petrinm/CellShaper/docs/top.png

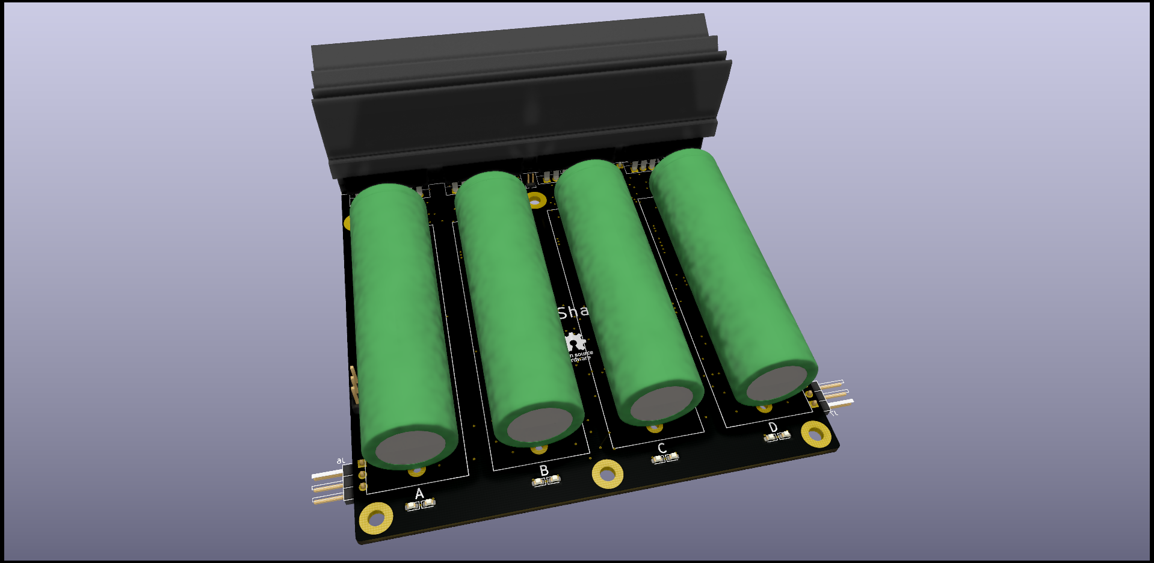
docs/top.png
