petrinm/CellShaper/docs/bottom.png

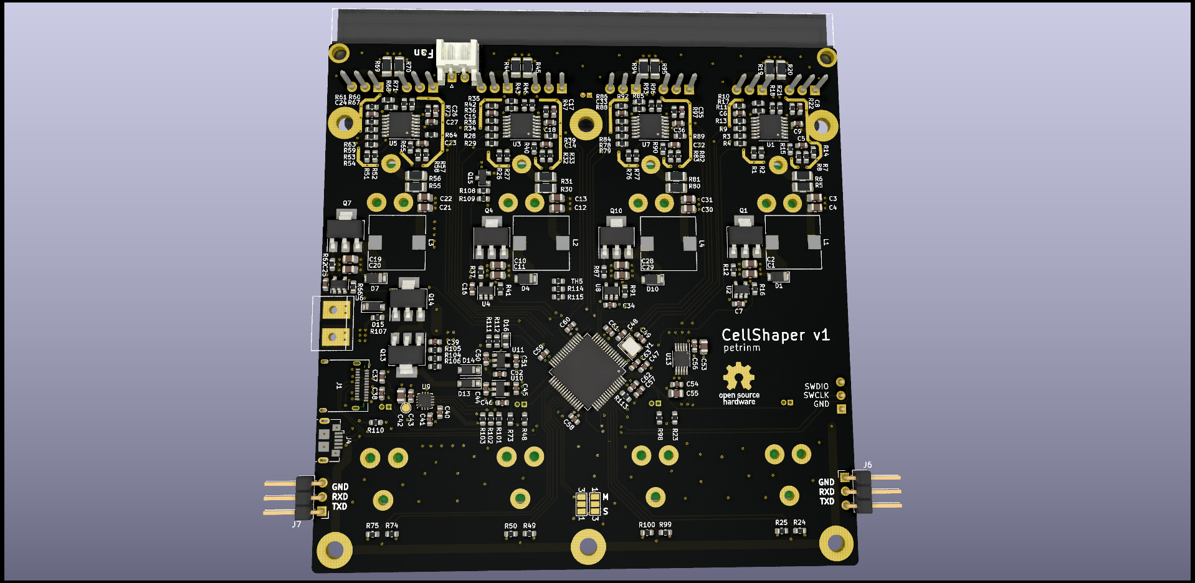
docs/bottom.png
