petrinm/CellShaper/README.md

# CellShaper
The ultimate 18650 battery cell tester
