petrinm/CellShaper/hw/v1/CellShaper.kicad_pcb

## KiCad design hw/v1/CellShaper.kicad_pcb (2020-07-15)

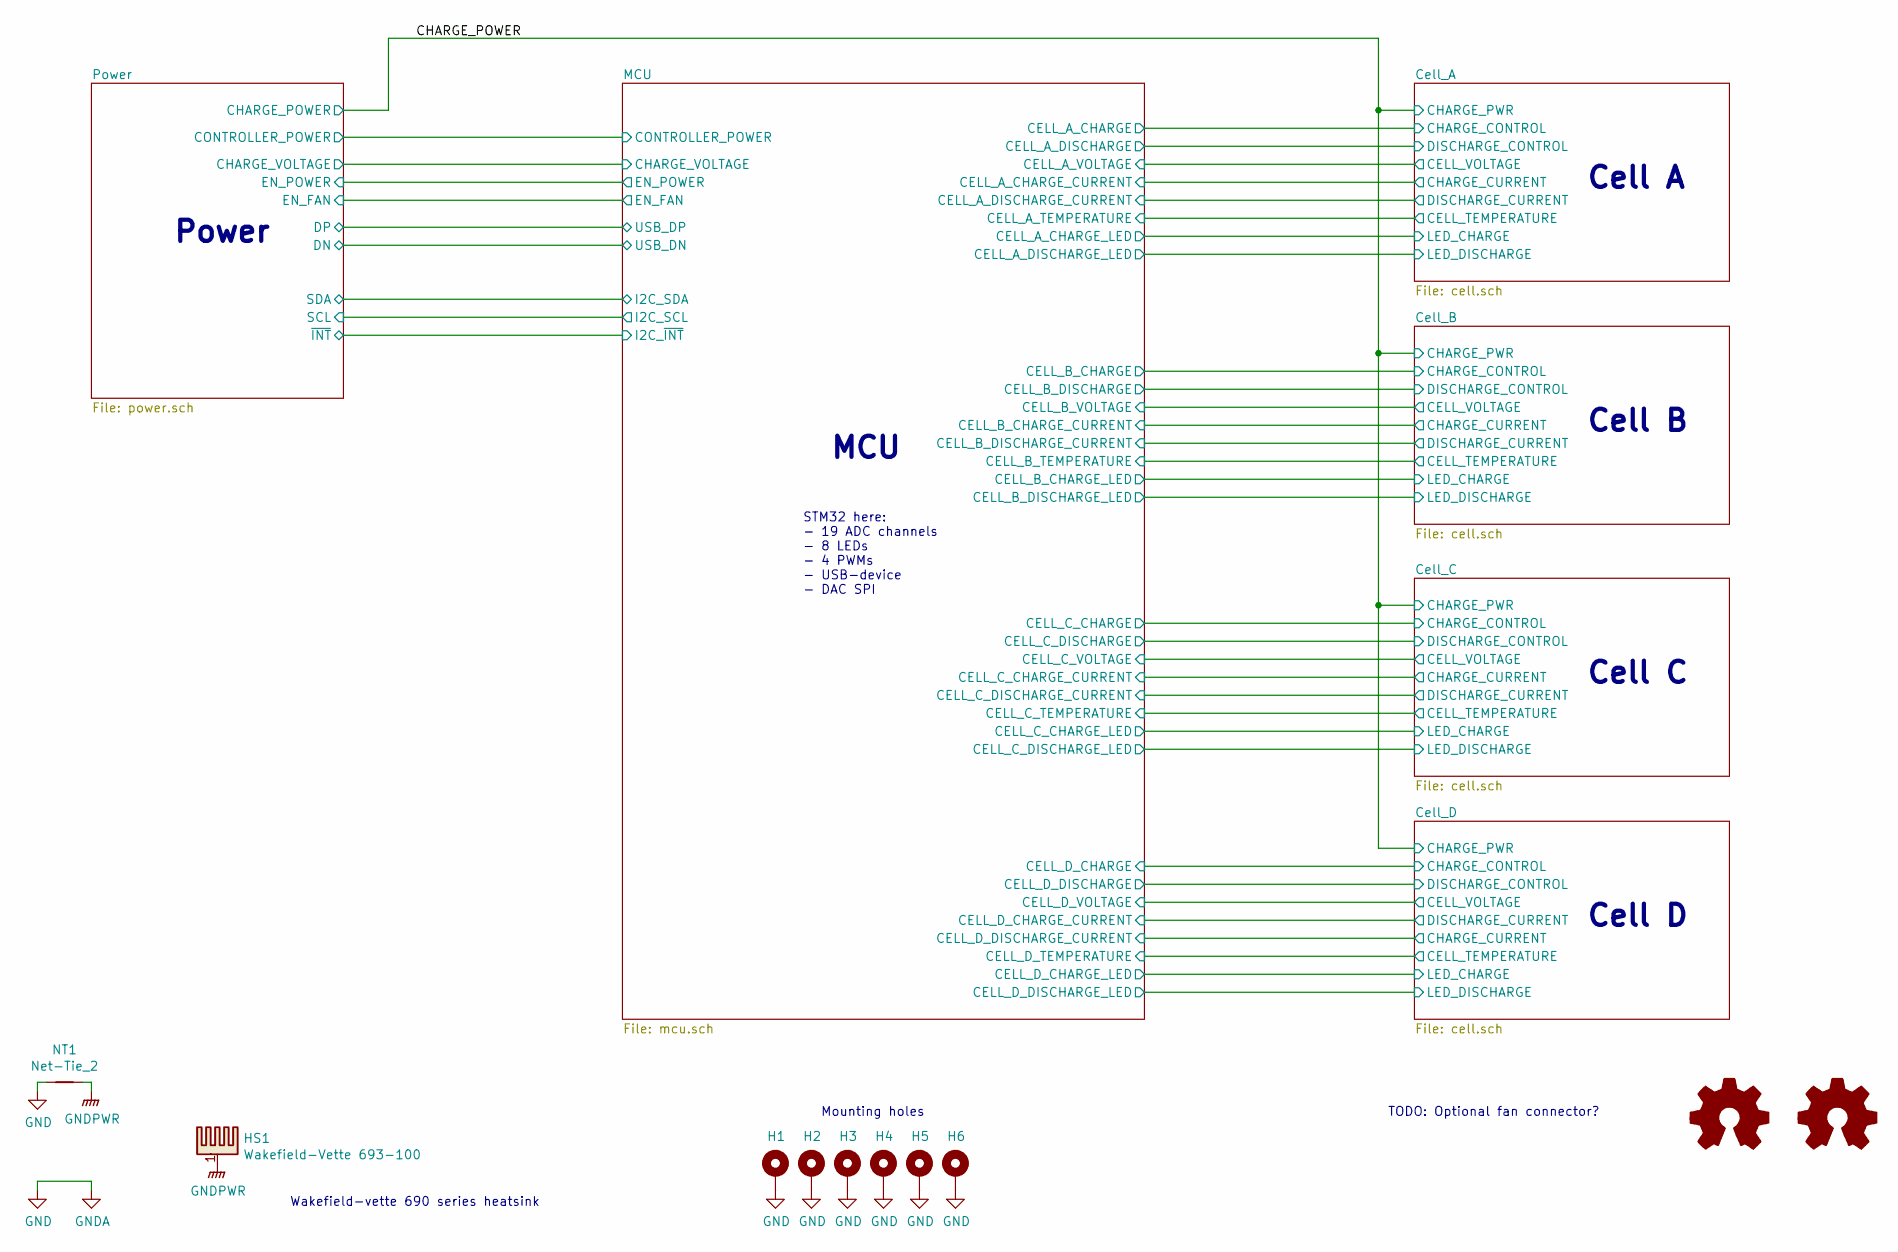
[picture p3: schematic CellShaper.sch]

Parts:
H1, H2, H3, H4, H5, H6: M3 hole; MountingHole_3.2mm_M3_Pad
HS1: Wakefield-Vette 693-100; Wakefield-vette_693-100
LOGO1: Logo_Open_Hardware_Small; OSHW-Logo_7.5x8mm_Copper
LOGO2: Logo_Open_Hardware_Small; OSHW-Logo_7.5x8mm_SilkScreen
NT1: Net-Tie_2; NetTie-2_SMD_Pad2.0mm

Connections:
GND: H1.1, H2.1, H3.1, H4.1, H5.1, H6.1, NT1.1; also elsewhere on the board
GNDPWR: HS1.1, NT1.2; also elsewhere on the board

Notes on the sheet:
Wakefield-vette 690 series heatsink
STM32 here: - 19 ADC channels - 8 LEDs - 4 PWMs - USB-device - DAC SPI
TODO: Optional fan connector?
Mounting holes
Cell A
Cell B
Cell D
Cell C
MCU
Power

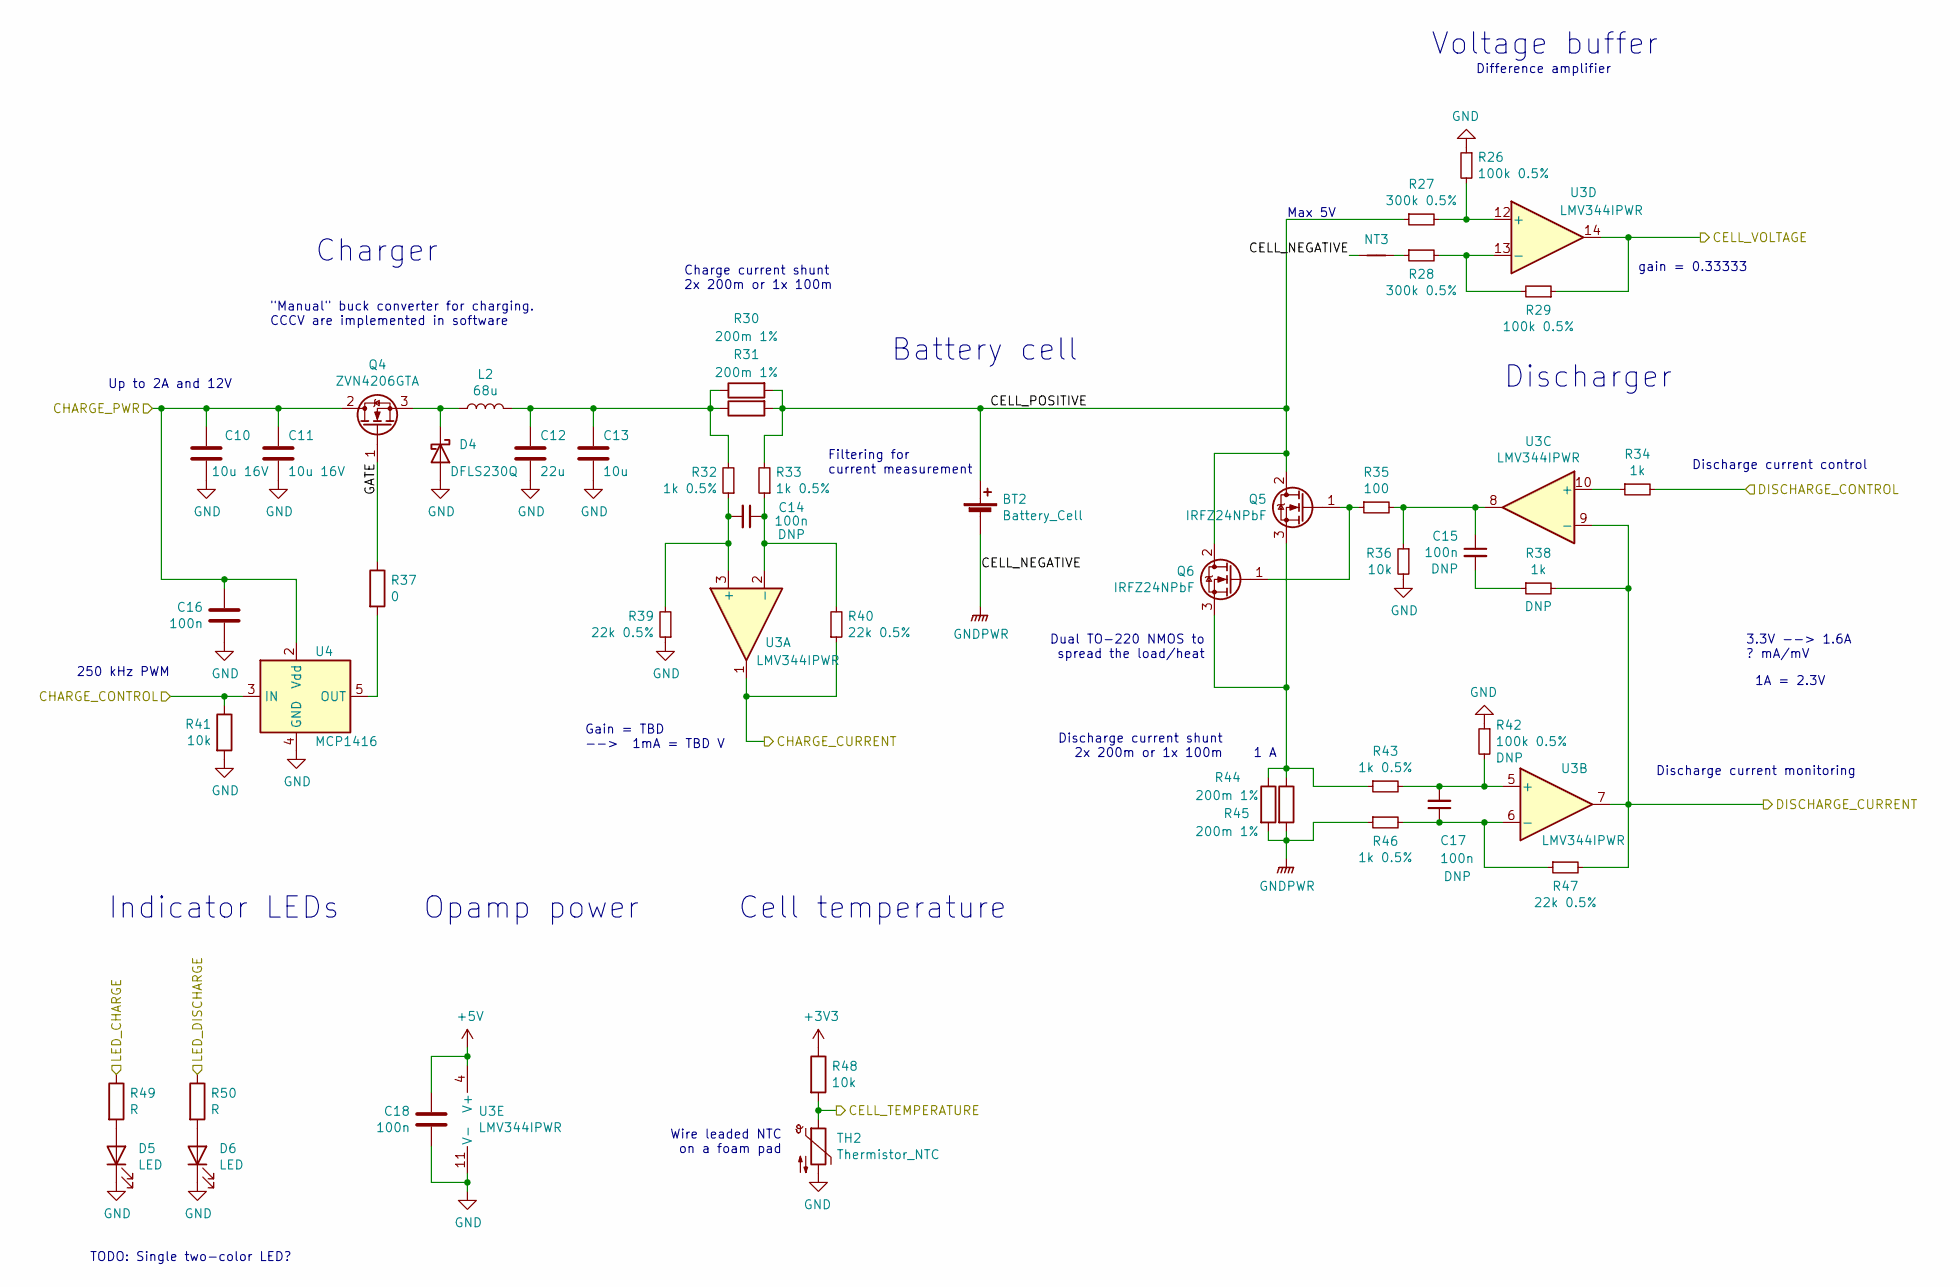
[picture p4: schematic cell.sch, CellShaper: Cell]

Parts:
BT1: Battery_Cell; BatteryHolder_Keystone_534_54
C1, C2: 10u 16V; C_0805_2012Metric
C3: 22u; C_0805_2012Metric
C4: 10u; C_0805_2012Metric
C5, C6, C7, C8, C9: 100n; C_0603_1608Metric
D1: DFLS230Q; D_PowerDI-123
D2, D3: LED; LED_0603_1608Metric
L1: 68u; L_Wuerth_HCM-1052
NT5: Net-Tie_2; NetTie-2_SMD_Pad0.5mm
Q1: ZVN4206GTA; SOT-223-3_TabPin2
Q2, Q3: IRFZ24NPbF; TO-220-3_Vertical
R1, R4, R17: 100k 0.5%; R_0603_1608Metric
R2, R3: 300k 0.5%; R_0603_1608Metric
R5, R6, R19, R20: 200m 1%; R_1206_3216Metric
R7, R8, R18, R21: 1k 0.5%; R_0603_1608Metric
R9, R13: 1k; R_0603_1608Metric
R10: 100; R_0603_1608Metric
R11, R16, R23: 10k; R_0603_1608Metric
R12: 0; R_0603_1608Metric
R14, R15, R22: 22k 0.5%; R_0603_1608Metric
R24, R25: R; R_0603_1608Metric
TH1: Thermistor_NTC; ContactThermistor
U1: LMV344IPWR; TSSOP-14_4.4x5mm_P0.65mm
U2: MCP1416; SOT-23-5

Connections:
+3V3: R23.1; also elsewhere on the board
+5V: C9.1, U1.4 (V+); also elsewhere on the board
/CHARGE_POWER: C1.1, C2.1, C7.1, Q1.2 (D), U2.2 (Vdd); also elsewhere on the board
/Cell_A/CELL_POSITIVE: BT1.1 (+), Q2.2 (D), Q3.2 (D), R2.1, R5.2, R6.2, R8.2
/Cell_A/GATE: Q1.1 (G), R12.1
/MCU/CELL_A_CHARGE: R16.1, U2.3 (IN); also elsewhere on the board
/MCU/CELL_A_CHARGE_CURRENT: R15.1, U1.1; also elsewhere on the board
/MCU/CELL_A_CHARGE_LED: R24.1; also elsewhere on the board
/MCU/CELL_A_DISCHARGE: R9.2; also elsewhere on the board
/MCU/CELL_A_DISCHARGE_CURRENT: R13.2, R22.2, U1.7, U1.9 (-); also elsewhere on the board
/MCU/CELL_A_DISCHARGE_LED: R25.1; also elsewhere on the board
/MCU/CELL_A_TEMPERATURE: R23.2, TH1.1; also elsewhere on the board
/MCU/CELL_A_VOLTAGE: R4.1, U1.14; also elsewhere on the board
GND: C1.2, C2.2, C3.2, C4.2, C7.2, C9.2, D1.2 (A), D2.1 (K), D3.1 (K), R1.1, R11.2, R14.1, R16.2, R17.1, TH1.2, U1.11 (V-), U2.4 (GND); also elsewhere on the board
GNDPWR: BT1.2 (-), NT5.1, R19.2, R20.2, R21.1; also elsewhere on the board
unnamed: C3.1, C4.1, L1.2, R5.1, R6.1, R7.2
unnamed: C5.1, R8.1, R15.2, U1.2 (-)
unnamed: C5.2, R7.1, R14.2, U1.3 (+)
unnamed: C6.1, R10.2, R11.1, U1.8
unnamed: C6.2, R13.1
unnamed: C8.1, R21.2, R22.1, U1.6 (-)
unnamed: C8.2, R17.2, R18.2, U1.5 (+)
unnamed: D1.1 (K), L1.1, Q1.3 (S)
unnamed: D2.2 (A), R24.2
unnamed: D3.2 (A), R25.2
unnamed: Q2.1 (G), Q3.1 (G), R10.1
unnamed: Q2.3 (S), Q3.3 (S), R18.1, R19.1, R20.1
unnamed: R1.2, R2.2, U1.12 (+)
unnamed: R3.2, R4.2, U1.13 (-)
unnamed: R9.1, U1.10 (+)
unnamed: R12.2, U2.5 (OUT)

Parts of its further copies:
BT2, BT3, BT4: Battery_Cell; BatteryHolder_Keystone_534_54
C10, C11, C19, C20, C28, C29: 10u 16V; C_0805_2012Metric
C12, C21, C30: 22u; C_0805_2012Metric
C13, C22, C31: 10u; C_0805_2012Metric
C14, C15, C16, C17, C18, C23, C24, C25, C26, C27, C32, C33, C34, C35, C36: 100n; C_0603_1608Metric
D4, D7, D10: DFLS230Q; D_PowerDI-123
D5, D6, D8, D9, D11, D12: LED; LED_0603_1608Metric
NT2, NT3, NT4: Net-Tie_2; NetTie-2_SMD_Pad0.5mm
Q4, Q7, Q10: ZVN4206GTA; SOT-223-3_TabPin2
Q5, Q6, Q8, Q9, Q11, Q12: IRFZ24NPbF; TO-220-3_Vertical
R26, R29, R42, R51, R54, R67, R76, R79, R92: 100k 0.5%; R_0603_1608Metric
R27, R28, R52, R53, R77, R78: 300k 0.5%; R_0603_1608Metric
R30, R31, R44, R45, R55, R56, R69, R70, R80, R81, R94, R95: 200m 1%; R_1206_3216Metric
R32, R33, R43, R46, R57, R58, R68, R71, R82, R83, R93, R96: 1k 0.5%; R_0603_1608Metric
R34, R38, R59, R63, R84, R88: 1k; R_0603_1608Metric
R35, R60, R85: 100; R_0603_1608Metric
R36, R41, R48, R61, R66, R73, R86, R91, R98: 10k; R_0603_1608Metric
R37, R62, R87: 0; R_0603_1608Metric
R39, R40, R47, R64, R65, R72, R89, R90, R97: 22k 0.5%; R_0603_1608Metric
R49, R50, R74, R75, R99, R100: R; R_0603_1608Metric
TH2, TH3, TH4: Thermistor_NTC; ContactThermistor
U3, U5, U7: LMV344IPWR; TSSOP-14_4.4x5mm_P0.65mm
U4, U6, U8: MCP1416; SOT-23-5

Connections of its further copies:
+3V3: R48.1, R73.1, R98.1; also elsewhere on the board
+5V: C18.1, C27.1, C36.1, U3.4 (V+), U5.4 (V+), U7.4 (V+); also elsewhere on the board
/CHARGE_POWER: C10.1, C11.1, C16.1, C19.1, C20.1, C25.1, C28.1, C29.1, C34.1, Q4.2 (D), Q7.2 (D), Q10.2 (D), U4.2 (Vdd), U6.2 (Vdd), U8.2 (Vdd); also elsewhere on the board
/Cell_B/CELL_POSITIVE: BT4.1 (+), Q11.2 (D), Q12.2 (D), R77.1, R80.2, R81.2, R83.2
/Cell_B/GATE: Q10.1 (G), R87.1
/Cell_C/CELL_POSITIVE: BT2.1 (+), Q5.2 (D), Q6.2 (D), R27.1, R30.2, R31.2, R33.2
/Cell_C/GATE: Q4.1 (G), R37.1
/Cell_D/CELL_POSITIVE: BT3.1 (+), Q8.2 (D), Q9.2 (D), R52.1, R55.2, R56.2, R58.2
/Cell_D/GATE: Q7.1 (G), R62.1
/MCU/CELL_B_CHARGE: R91.1, U8.3 (IN); also elsewhere on the board
/MCU/CELL_B_CHARGE_CURRENT: R90.1, U7.1; also elsewhere on the board
/MCU/CELL_B_CHARGE_LED: R99.1; also elsewhere on the board
/MCU/CELL_B_DISCHARGE: R84.2; also elsewhere on the board
/MCU/CELL_B_DISCHARGE_CURRENT: R88.2, R97.2, U7.7, U7.9 (-); also elsewhere on the board
/MCU/CELL_B_DISCHARGE_LED: R100.1; also elsewhere on the board
/MCU/CELL_B_TEMPERATURE: R98.2, TH4.1; also elsewhere on the board
/MCU/CELL_B_VOLTAGE: R79.1, U7.14; also elsewhere on the board
/MCU/CELL_C_CHARGE: R41.1, U4.3 (IN); also elsewhere on the board
/MCU/CELL_C_CHARGE_CURRENT: R40.1, U3.1; also elsewhere on the board
/MCU/CELL_C_CHARGE_LED: R49.1; also elsewhere on the board
/MCU/CELL_C_DISCHARGE: R34.2; also elsewhere on the board
/MCU/CELL_C_DISCHARGE_CURRENT: R38.2, R47.2, U3.7, U3.9 (-); also elsewhere on the board
/MCU/CELL_C_DISCHARGE_LED: R50.1; also elsewhere on the board
/MCU/CELL_C_TEMPERATURE: R48.2, TH2.1; also elsewhere on the board
/MCU/CELL_C_VOLTAGE: R29.1, U3.14; also elsewhere on the board
/MCU/CELL_D_CHARGE: R66.1, U6.3 (IN); also elsewhere on the board
/MCU/CELL_D_CHARGE_CURRENT: R63.2, R72.2, U5.7, U5.9 (-); also elsewhere on the board
/MCU/CELL_D_CHARGE_LED: R74.1; also elsewhere on the board
/MCU/CELL_D_DISCHARGE: R59.2; also elsewhere on the board
/MCU/CELL_D_DISCHARGE_CURRENT: R65.1, U5.1; also elsewhere on the board
/MCU/CELL_D_DISCHARGE_LED: R75.1; also elsewhere on the board
/MCU/CELL_D_TEMPERATURE: R73.2, TH3.1; also elsewhere on the board
/MCU/CELL_D_VOLTAGE: R54.1, U5.14; also elsewhere on the board
GND: C10.2, C11.2, C12.2, C13.2, C16.2, C18.2, C19.2, C20.2, C21.2, C22.2, C25.2, C27.2, C28.2, C29.2, C30.2, C31.2, C34.2, C36.2, D4.2 (A), D5.1 (K), D6.1 (K), D7.2 (A), D8.1 (K), D9.1 (K), D10.2 (A), D11.1 (K), D12.1 (K), R26.1, R36.2, R39.1, R41.2, R42.1, R51.1, R61.2, R64.1, R66.2, R67.1, R76.1, R86.2, R89.1, R91.2, R92.1, TH2.2, TH3.2, TH4.2, U3.11 (V-), U4.4 (GND), U5.11 (V-), U6.4 (GND), U7.11 (V-), U8.4 (GND); also elsewhere on the board
GNDPWR: BT2.2 (-), BT3.2 (-), BT4.2 (-), NT2.1, NT3.1, NT4.1, R44.2, R45.2, R46.1, R69.2, R70.2, R71.1, R94.2, R95.2, R96.1; also elsewhere on the board
unnamed 78: C12.1, C13.1, R30.1, R31.1, R32.2; also elsewhere on the board
unnamed: C14.1, R33.1, R40.2, U3.2 (-)
unnamed: C14.2, R32.1, R39.2, U3.3 (+)
unnamed: C15.1, R35.2, R36.1, U3.8
unnamed: C15.2, R38.1
unnamed: C17.1, R46.2, R47.1, U3.6 (-)
unnamed: C17.2, R42.2, R43.2, U3.5 (+)
unnamed 85: C21.1, C22.1, R55.1, R56.1, R57.2; also elsewhere on the board
unnamed: C23.1, R58.1, R65.2, U5.2 (-)
unnamed: C23.2, R57.1, R64.2, U5.3 (+)
unnamed: C24.1, R60.2, R61.1, U5.8
unnamed: C24.2, R63.1
unnamed: C26.1, R71.2, R72.1, U5.6 (-)
unnamed: C26.2, R67.2, R68.2, U5.5 (+)
unnamed 92: C30.1, C31.1, R80.1, R81.1, R82.2; also elsewhere on the board
unnamed: C32.1, R83.1, R90.2, U7.2 (-)
unnamed: C32.2, R82.1, R89.2, U7.3 (+)
unnamed: C33.1, R85.2, R86.1, U7.8
unnamed: C33.2, R88.1
unnamed: C35.1, R96.2, R97.1, U7.6 (-)
unnamed: C35.2, R92.2, R93.2, U7.5 (+)
unnamed 106: D4.1 (K), Q4.3 (S); also elsewhere on the board
unnamed: D5.2 (A), R49.2
unnamed: D6.2 (A), R50.2
unnamed 109: D7.1 (K), Q7.3 (S); also elsewhere on the board
unnamed: D8.2 (A), R74.2
unnamed: D9.2 (A), R75.2
unnamed 112: D10.1 (K), Q10.3 (S); also elsewhere on the board
unnamed: D11.2 (A), R99.2
unnamed: D12.2 (A), R100.2
unnamed: NT3.2, R28.1
unnamed: NT4.2, R53.1
unnamed: Q5.1 (G), Q6.1 (G), R35.1
unnamed: Q5.3 (S), Q6.3 (S), R43.1, R44.1, R45.1
unnamed: Q8.1 (G), Q9.1 (G), R60.1
unnamed: Q8.3 (S), Q9.3 (S), R68.1, R69.1, R70.1
unnamed: Q11.1 (G), Q12.1 (G), R85.1
unnamed: Q11.3 (S), Q12.3 (S), R93.1, R94.1, R95.1
unnamed: R26.2, R27.2, U3.12 (+)
unnamed: R28.2, R29.2, U3.13 (-)
unnamed: R34.1, U3.10 (+)
unnamed: R37.2, U4.5 (OUT)
unnamed: R51.2, R52.2, U5.12 (+)
unnamed: R53.2, R54.2, U5.13 (-)
unnamed: R59.1, U5.10 (+)
unnamed: R62.2, U6.5 (OUT)
unnamed: R76.2, R77.2, U7.12 (+)
unnamed: R78.2, R79.2, U7.13 (-)
unnamed: R84.1, U7.10 (+)
unnamed: R87.2, U8.5 (OUT)

Notes on the sheet:
1 A
Indicator LEDs
Discharger
Battery cell
Charger
Voltage buffer
250 kHz PWM
"Manual" buck converter for charging. CCCV are implemented in software
Charge current shunt 2x 200m or 1x 100m
Discharge current monitoring
Dual TO-220 NMOS to spread the load/heat
Filtering for current measurement
Gain = TBD --> 1mA = TBD V
Cell temperature
Opamp power
Up to 2A and 12V
Wire leaded NTC on a foam pad
TODO: Single two-color LED?
3.3V --> 1.6A ? mA/mV
Max 5V
1A = 2.3V
Difference amplifier
gain = 0.33333
Discharge current control
Discharge current shunt 2x 200m or 1x 100m

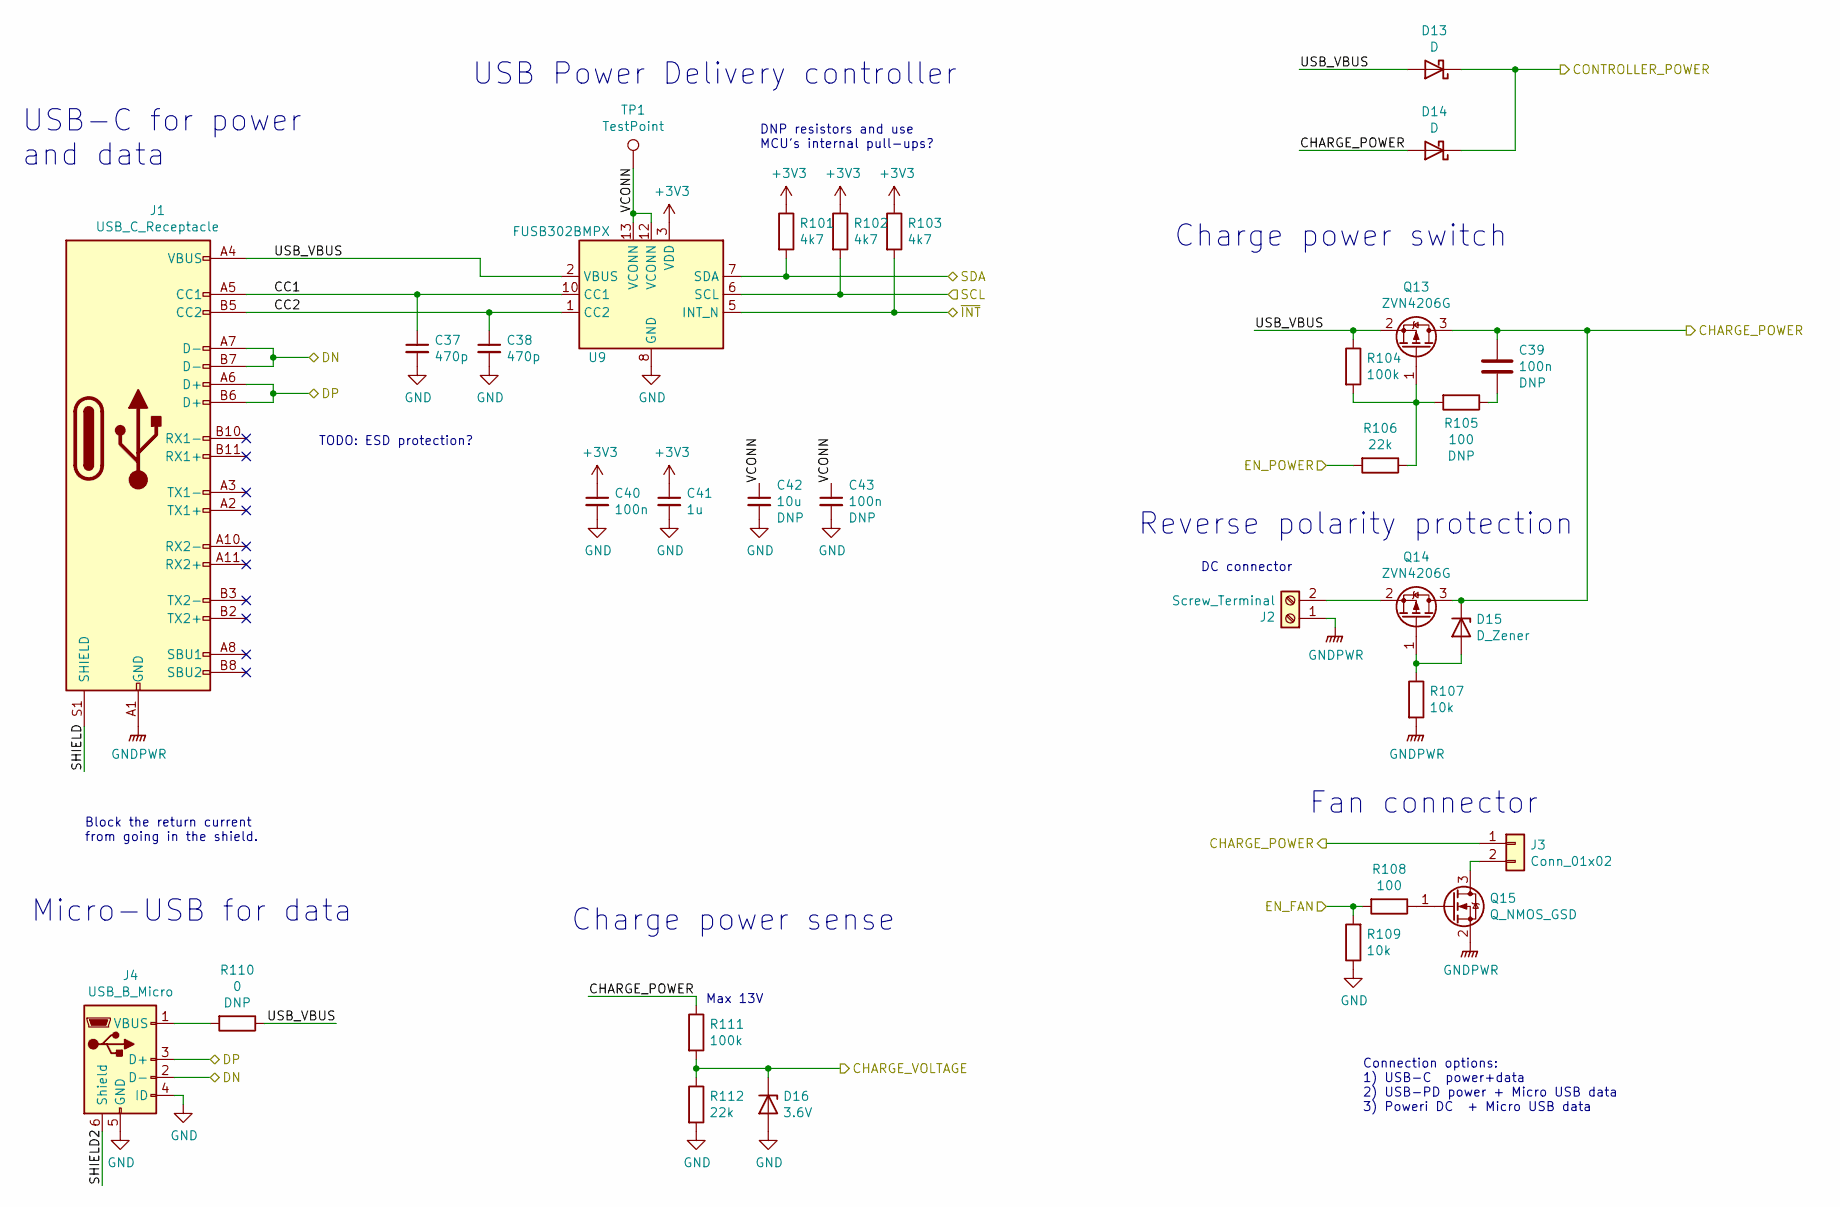
[picture p5: schematic power.sch, Cell Shaper: Power]

Parts:
C37, C38: 470p; C_0603_1608Metric
C39, C40, C43: 100n; C_0603_1608Metric
C41: 1u; C_0603_1608Metric
C42: 10u; C_0805_2012Metric
D13, D14: D; D_SOD-123
D15: D_Zener; D_SOD-123
D16: 3.6V; D_SOD-110
J1: USB_C_Receptacle; USB_C_Receptacle_Amphenol_12401610E4-2A
J2: Screw_Terminal; TerminalBlock_bornier-2_P5.08mm
J3: Conn_01x02; JST_EH_S2B-EH_1x02_P2.50mm_Horizontal
J4: USB_B_Micro; USB_Micro-B_GCT_USB3076-30-A
Q13, Q14: ZVN4206G; SOT-223-3_TabPin2
Q15: Q_NMOS_GSD; SOT-23
R101, R102, R103: 4k7; R_0603_1608Metric
R104, R111: 100k; R_0603_1608Metric
R105, R108: 100; R_0603_1608Metric
R106, R112: 22k; R_0603_1608Metric
R107, R109: 10k; R_0603_1608Metric
R110: 0; R_0603_1608Metric
TP1: TestPoint; TestPoint_Pad_D1.5mm
U9: FUSB302BMPX; WQFN-14-1EP_2.5x2.5mm_P0.5mm_EP1.45x1.45mm

Connections:
+3V3: C40.1, C41.1, R101.1, R102.1, R103.1, U9.3 (VDD), U9.4 (VDD); also elsewhere on the board
/CHARGE_POWER: C39.1, D14.2 (A), D15.1 (K), J3.1, Q13.3 (D), Q14.3 (D), R111.1; also elsewhere on the board
/MCU/CHARGE_VOLTAGE: D16.1 (K), R111.2, R112.1; also elsewhere on the board
/MCU/CONTROLLER_POWER: D13.1 (K), D14.1 (K); also elsewhere on the board
/MCU/EN_FAN: R108.2, R109.2; also elsewhere on the board
/MCU/EN_POWER: R106.2; also elsewhere on the board
/MCU/I2C_SCL: R102.2, U9.6 (SCL); also elsewhere on the board
/MCU/I2C_SDA: R101.2, U9.7 (SDA); also elsewhere on the board
/MCU/I2C_~INT: R103.2, U9.5 (INT_N); also elsewhere on the board
/Power/CC1: C37.1, J1.A5 (CC1), U9.10 (CC1), U9.11 (CC1)
/Power/CC2: C38.1, J1.B5 (CC2), U9.1 (CC2), U9.14 (CC2)
/Power/DN: J1.A7 (D-), J1.B7 (D-), J4.2 (D-); also elsewhere on the board
/Power/DP: J1.A6 (D+), J1.B6 (D+), J4.3 (D+); also elsewhere on the board
/Power/SHIELD: J1.S1 (SHIELD)
/Power/SHIELD2: J4.6 (Shield)
/Power/USB_VBUS: D13.2 (A), J1.A4 (VBUS), J1.A9 (VBUS), J1.B4 (VBUS), J1.B9 (VBUS), Q13.2 (S), R104.1, R110.1, U9.2 (VBUS)
/Power/VCONN: C42.1, C43.1, TP1.1, U9.12 (VCONN), U9.13 (VCONN)
GND: C37.2, C38.2, C40.2, C41.2, C42.2, C43.2, D16.2 (A), J4.4 (ID), J4.5 (GND), R109.1, R112.2, U9.8 (GND), U9.9 (GND), U9.15 (GND); also elsewhere on the board
GNDPWR: J1.A1 (GND), J1.A12 (GND), J1.B1 (GND), J1.B12 (GND), J2.1, Q15.2 (S), R107.2; also elsewhere on the board
unnamed: C39.2, R105.1
unnamed: D15.2 (A), Q14.1 (G), R107.1
unnamed: J2.2, Q14.2 (S)
unnamed: J3.2, Q15.3 (D)
unnamed: J4.1 (VBUS), R110.2
unnamed: Q13.1 (G), R104.2, R105.2, R106.1
unnamed: Q15.1 (G), R108.1

Notes on the sheet:
Max 13V
Reverse polarity protection
Charge power sense
USB Power Delivery controller
Connection options: 1) USB-C power+data 2) USB-PD power + Micro USB data 3) Poweri DC + Micro USB data
DNP resistors and use MCU's internal pull-ups?
Block the return current from going in the shield.
TODO: ESD protection?
Charge power switch
DC connector
Fan connector
Micro-USB for data
USB-C for power and data

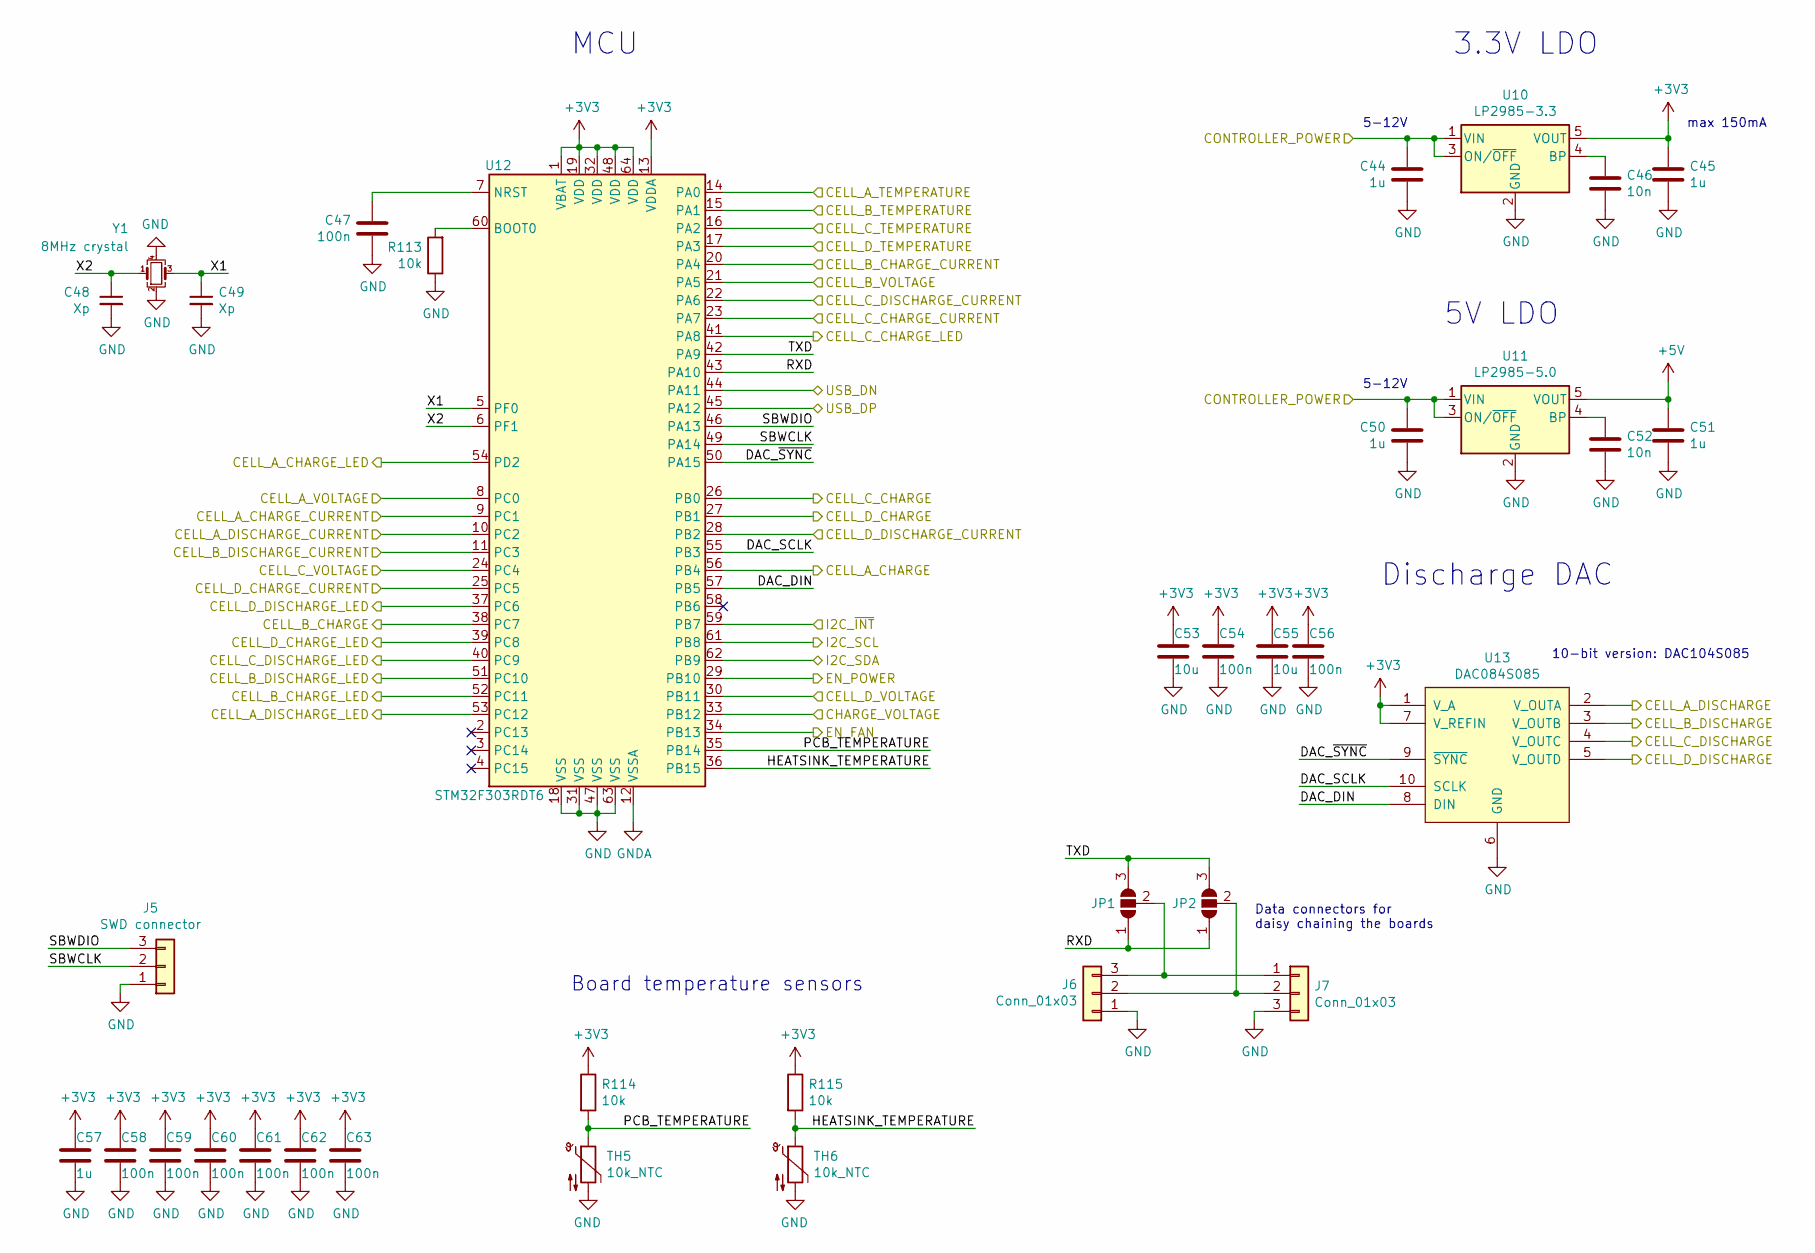
[picture p6: schematic mcu.sch, CellShaper: MCU]

Parts:
C44, C45, C50, C51, C57: 1u; C_0603_1608Metric
C46, C52: 10n; C_0603_1608Metric
C47, C54, C56, C58, C59, C60, C61, C62, C63: 100n; C_0603_1608Metric
C48, C49: Xp; C_0603_1608Metric
C53, C55: 10u; C_0805_2012Metric
J5: SWD connector; PinHeader_1x03_P2.54mm_Vertical
J6, J7: Conn_01x03; PinHeader_1x03_P2.54mm_Horizontal
JP1, JP2: SolderJumper_3_Open; SolderJumper-3_P1.3mm_Open_Pad1.0x1.5mm_NumberLabels
R113, R114, R115: 10k; R_0603_1608Metric
TH5: 10k_NTC; R_0603_1608Metric
TH6: 10k_NTC; PinHeader_1x02_P1.27mm_Vertical
U10: LP2985-3.3; SOT-23-5
U11: LP2985-5.0; SOT-23-5
U12: STM32F303RDT6; LQFP-64_10x10mm_P0.5mm
U13: DAC084S085; VSSOP-10_3x3mm_P0.5mm
Y1: 8MHz crystal; Crystal_SMD_Abracon_ABM8G-4Pin_3.2x2.5mm

Connections:
+3V3: C45.1, C53.2, C54.2, C55.2, C56.1, C57.1, C58.1, C59.1, C60.1, C61.1, C62.1, C63.1, R114.1, R115.1, U10.5 (VOUT), U12.1 (VBAT), U12.13 (VDDA), U12.19 (VDD), U12.32 (VDD), U12.48 (VDD), U12.64 (VDD), U13.1 (V_A), U13.7 (V_REFIN); also elsewhere on the board
+5V: C51.1, U11.5 (VOUT); also elsewhere on the board
/MCU/CELL_A_CHARGE: U12.56 (PB4); also elsewhere on the board
/MCU/CELL_A_CHARGE_CURRENT: U12.9 (PC1); also elsewhere on the board
/MCU/CELL_A_CHARGE_LED: U12.54 (PD2); also elsewhere on the board
/MCU/CELL_A_DISCHARGE: U13.2 (V_OUTA); also elsewhere on the board
/MCU/CELL_A_DISCHARGE_CURRENT: U12.10 (PC2); also elsewhere on the board
/MCU/CELL_A_DISCHARGE_LED: U12.53 (PC12); also elsewhere on the board
/MCU/CELL_A_TEMPERATURE: U12.14 (PA0); also elsewhere on the board
/MCU/CELL_A_VOLTAGE: U12.8 (PC0); also elsewhere on the board
/MCU/CELL_B_CHARGE: U12.38 (PC7); also elsewhere on the board
/MCU/CELL_B_CHARGE_CURRENT: U12.20 (PA4); also elsewhere on the board
/MCU/CELL_B_CHARGE_LED: U12.52 (PC11); also elsewhere on the board
/MCU/CELL_B_DISCHARGE: U13.3 (V_OUTB); also elsewhere on the board
/MCU/CELL_B_DISCHARGE_CURRENT: U12.11 (PC3); also elsewhere on the board
/MCU/CELL_B_DISCHARGE_LED: U12.51 (PC10); also elsewhere on the board
/MCU/CELL_B_TEMPERATURE: U12.15 (PA1); also elsewhere on the board
/MCU/CELL_B_VOLTAGE: U12.21 (PA5); also elsewhere on the board
/MCU/CELL_C_CHARGE: U12.26 (PB0); also elsewhere on the board
/MCU/CELL_C_CHARGE_CURRENT: U12.23 (PA7); also elsewhere on the board
/MCU/CELL_C_CHARGE_LED: U12.41 (PA8); also elsewhere on the board
/MCU/CELL_C_DISCHARGE: U13.4 (V_OUTC); also elsewhere on the board
/MCU/CELL_C_DISCHARGE_CURRENT: U12.22 (PA6); also elsewhere on the board
/MCU/CELL_C_DISCHARGE_LED: U12.40 (PC9); also elsewhere on the board
/MCU/CELL_C_TEMPERATURE: U12.16 (PA2); also elsewhere on the board
/MCU/CELL_C_VOLTAGE: U12.24 (PC4); also elsewhere on the board
/MCU/CELL_D_CHARGE: U12.27 (PB1); also elsewhere on the board
/MCU/CELL_D_CHARGE_CURRENT: U12.25 (PC5); also elsewhere on the board
/MCU/CELL_D_CHARGE_LED: U12.39 (PC8); also elsewhere on the board
/MCU/CELL_D_DISCHARGE: U13.5 (V_OUTD); also elsewhere on the board
/MCU/CELL_D_DISCHARGE_CURRENT: U12.28 (PB2); also elsewhere on the board
/MCU/CELL_D_DISCHARGE_LED: U12.37 (PC6); also elsewhere on the board
/MCU/CELL_D_TEMPERATURE: U12.17 (PA3); also elsewhere on the board
/MCU/CELL_D_VOLTAGE: U12.30 (PB11); also elsewhere on the board
/MCU/CHARGE_VOLTAGE: U12.33 (PB12); also elsewhere on the board
/MCU/CONTROLLER_POWER: C44.1, C50.1, U10.1 (VIN), U10.3 (ON/~OFF~), U11.1 (VIN), U11.3 (ON/~OFF~); also elsewhere on the board
/MCU/DAC_DIN: U12.57 (PB5), U13.8 (DIN)
/MCU/DAC_SCLK: U12.55 (PB3), U13.10 (SCLK)
/MCU/DAC_~SYNC: U12.50 (PA15), U13.9 (~SYNC)
/MCU/EN_FAN: U12.34 (PB13); also elsewhere on the board
/MCU/EN_POWER: U12.29 (PB10); also elsewhere on the board
/MCU/HEATSINK_TEMPERATURE: R115.2, TH6.1, U12.36 (PB15)
/MCU/I2C_SCL: U12.61 (PB8); also elsewhere on the board
/MCU/I2C_SDA: U12.62 (PB9); also elsewhere on the board
/MCU/I2C_~INT: U12.59 (PB7); also elsewhere on the board
/MCU/PCB_TEMPERATURE: R114.2, TH5.1, U12.35 (PB14)
/MCU/RXD: JP1.1 (A), JP2.1 (A), U12.43 (PA10)
/MCU/SBWCLK: J5.2, U12.49 (PA14)
/MCU/SBWDIO: J5.3, U12.46 (PA13)
/MCU/TXD: JP1.3 (B), JP2.3 (B), U12.42 (PA9)
/MCU/X1: C49.1, U12.5 (PF0), Y1.3
/MCU/X2: C48.1, U12.6 (PF1), Y1.1
/Power/DN: U12.44 (PA11); also elsewhere on the board
/Power/DP: U12.45 (PA12); also elsewhere on the board
GND: C44.2, C45.2, C46.2, C47.2, C48.2, C49.2, C50.2, C51.2, C52.2, C53.1, C54.1, C55.1, C56.2, C57.2, C58.2, C59.2, C60.2, C61.2, C62.2, C63.2, J5.1, J6.1, J7.3, R113.1, TH5.2, TH6.2, U10.2 (GND), U11.2 (GND), U12.12 (VSSA), U12.18 (VSS), U12.31 (VSS), U12.47 (VSS), U12.63 (VSS), U13.6 (GND), Y1.2, Y1.4; also elsewhere on the board
unnamed: C46.1, U10.4 (BP)
unnamed: C47.1, U12.7 (NRST)
unnamed: C52.1, U11.4 (BP)
unnamed: J6.2, J7.2, JP2.2 (C)
unnamed: J6.3, J7.1, JP1.2 (C)
unnamed: R113.2, U12.60 (BOOT0)

Notes on the sheet:
Data connectors for daisy chaining the boards
Board temperature sensors
10-bit version: DAC104S085
Discharge DAC
3.3V LDO
max 150mA
5-12V
5V LDO
MCU

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
