petrinm/CellShaper/hw/v1/CellShaper.kicad_pcb

## KiCad design hw/v1/CellShaper.kicad_pcb (continued)

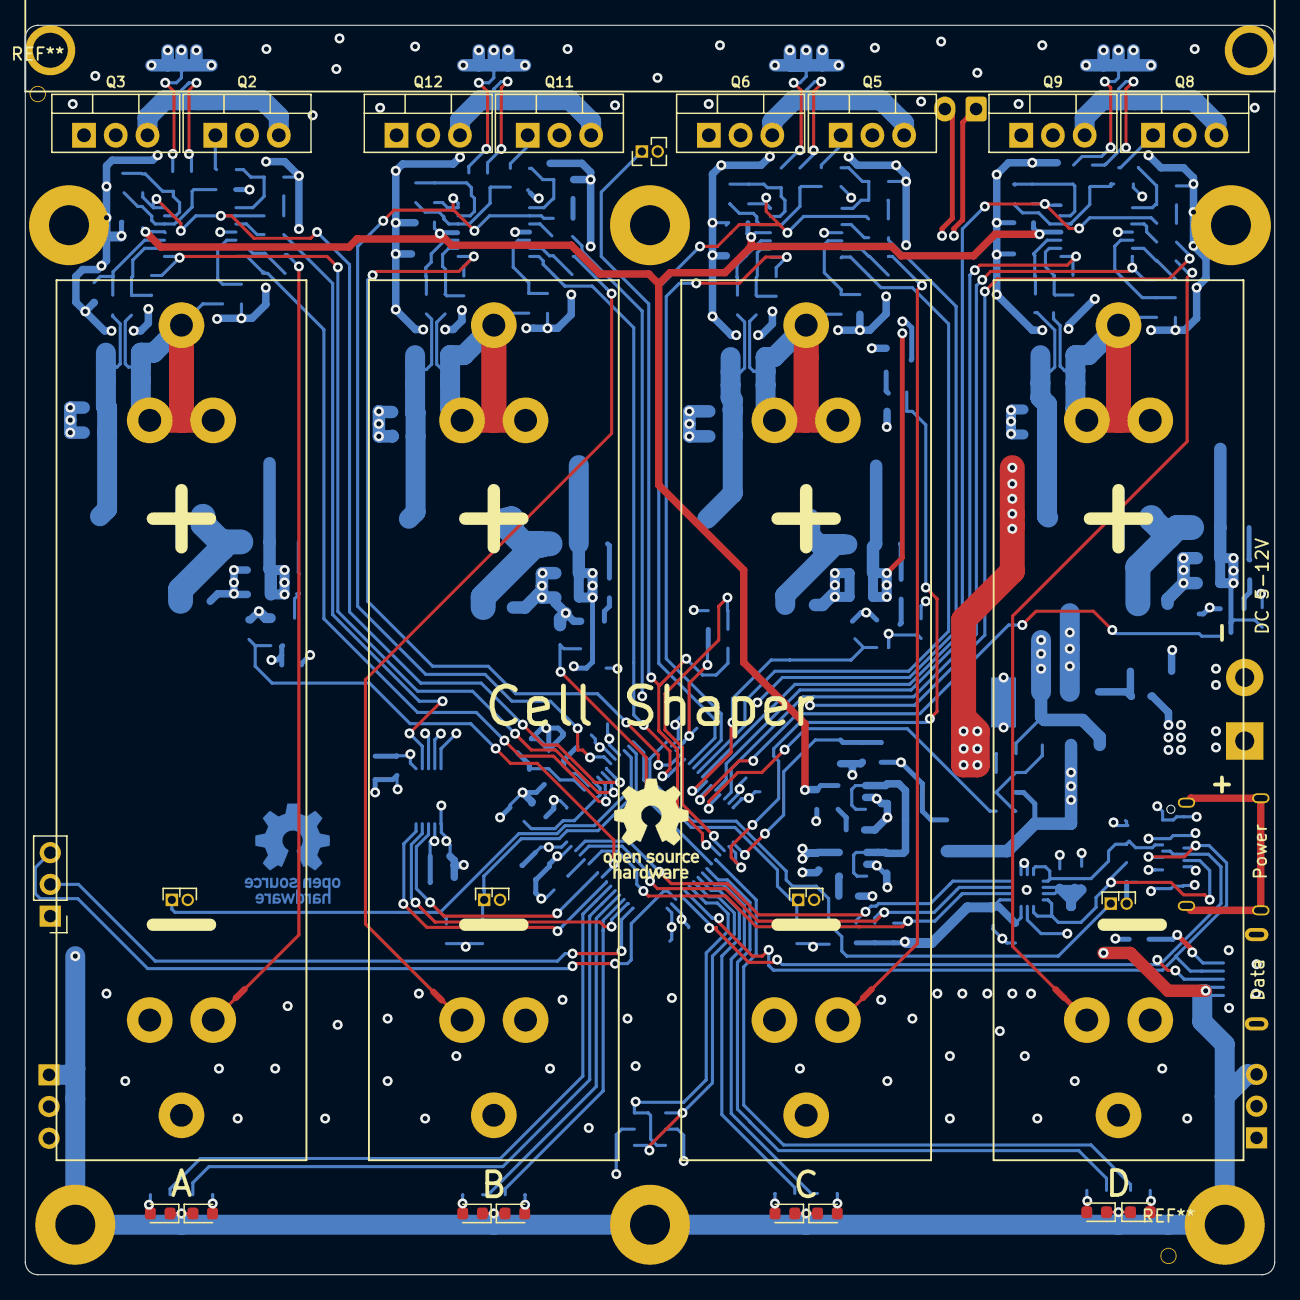
[picture p7: board CellShaper.kicad_pcb from above]

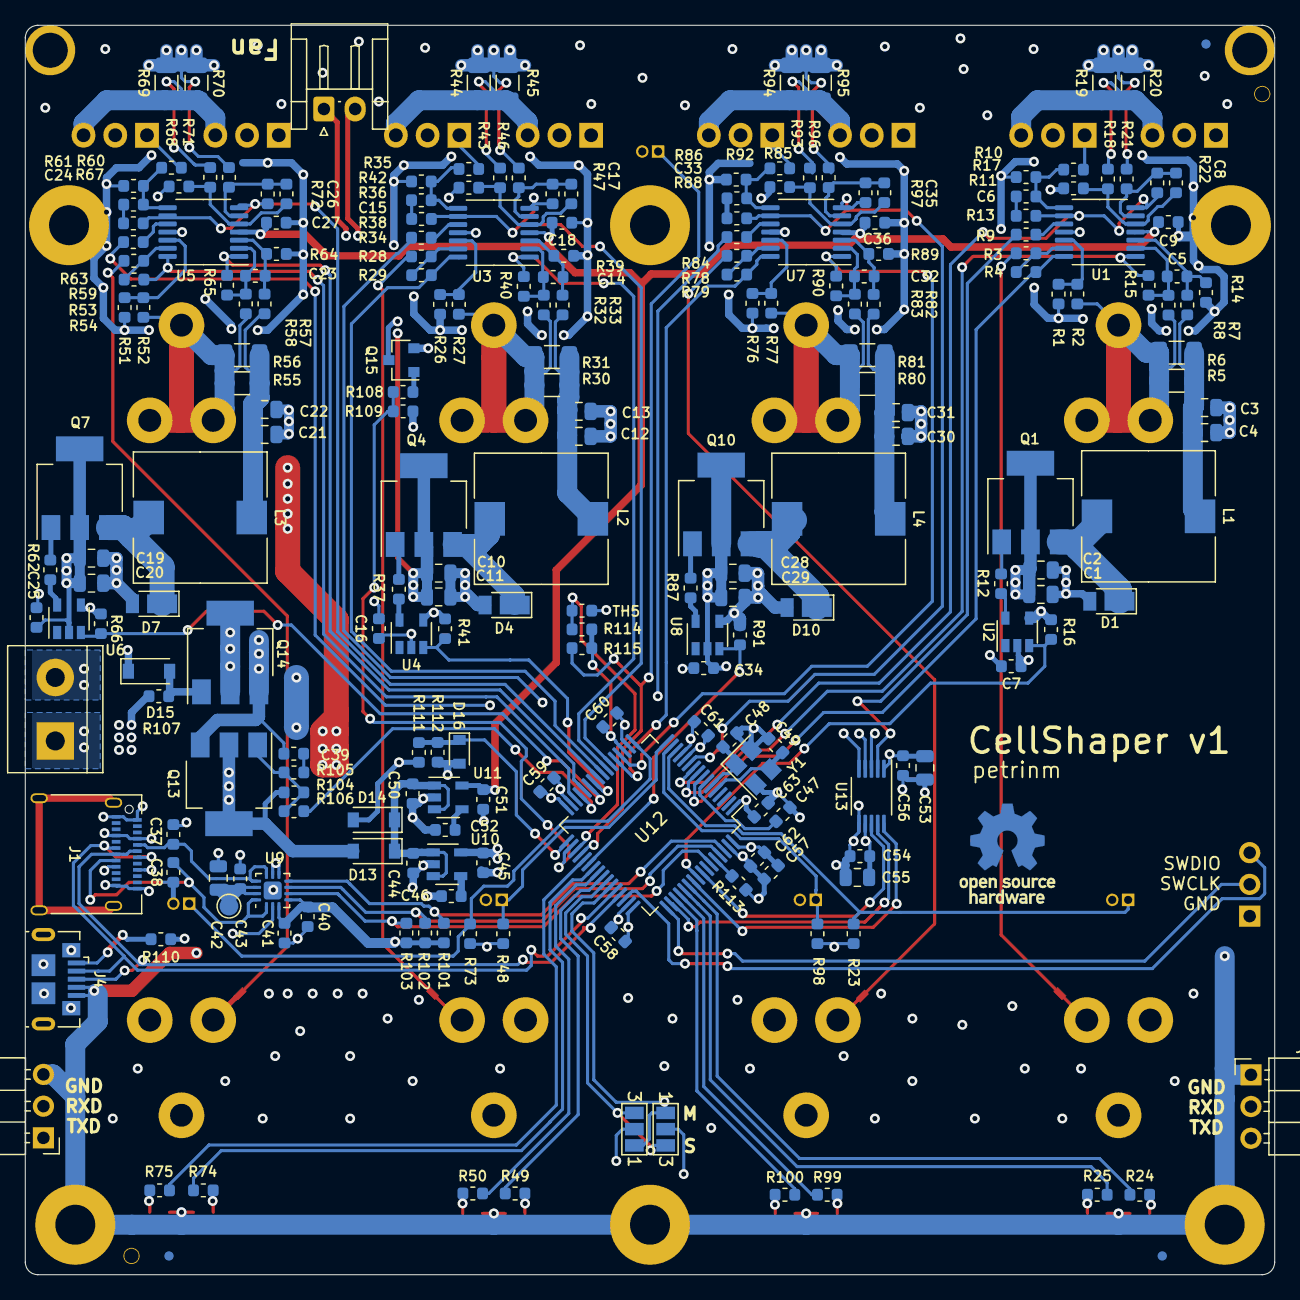
[picture p8: board CellShaper.kicad_pcb from below]

Board: 4 copper layers, 100.0 x 100.0 mm, 262 parts (224 on the bottom side), 150 nets.

Other parts of the board:
L2, L3, L4: 100u; L_Wuerth_HCM-1052
LOGO1#2: Logo_Open_Hardware_Small; OSHW-Logo_7.5x8mm_Copper

Their connections:
unnamed 78: L2.2; also elsewhere on the board
unnamed 85: L3.2; also elsewhere on the board
unnamed 92: L4.2; also elsewhere on the board
unnamed 106: L2.1; also elsewhere on the board
unnamed 109: L3.1; also elsewhere on the board
unnamed 112: L4.1; also elsewhere on the board
