petrinm/CellShaper/fw/fw.ioc

Mcu.UserName=STM32F303RBTx
PA0.Signal=ADC1_IN1
PA1.Signal=ADC1_IN2
PA10.GPIO_Label=RXD
PA10.Signal=USART1_RX
PA11.Signal=USB_DM
PA12.Signal=USB_DP
PA13.Signal=SYS_JTMS-SWDIO
PA14.Signal=SYS_JTCK-SWCLK
PA15.Signal=SPI1_NSS
PA2.Signal=ADC1_IN3
PA3.Signal=ADC1_IN4
PA4.Signal=ADC2_IN1
PA5.Signal=ADC2_IN2
PA6.Signal=ADC2_IN3
PA7.Signal=ADC2_IN4
PA8.Signal=GPIO_Output
PA9.GPIO_Label=TXD
PA9.Signal=USART1_TX
PB0.Signal=ADC3_IN12
PB1.Signal=S_TIM3_CH4
PB13.Signal=ADC3_IN5
PB14.Signal=GPIO_Output
PB15.Signal=GPIO_Output
PB2.Signal=ADC2_IN12
PB3.Signal=SPI1_SCK
PB4.Signal=GPXTI4
PB5.Signal=SPI1_MOSI
PB6.Signal=I2C1_SCL
PB7.Signal=I2C1_SDA
PC0.Signal=ADCx_IN6
PC1.Signal=ADCx_IN7
PC10.Signal=GPIO_Output
PC11.Signal=GPIO_Output
PC12.Signal=GPIO_Output
PC2.Signal=ADCx_IN8
PC3.Signal=ADCx_IN9
PC4.Signal=ADC2_IN5
PC5.Signal=ADC2_IN11
PC6.Signal=S_TIM3_CH1
PC7.Signal=S_TIM3_CH2
PC8.Signal=S_TIM3_CH3
PC9.Signal=GPIO_Output
PD2.Signal=GPIO_Output
PF0-OSC_IN.Signal=RCC_OSC_IN
PF1-OSC_OUT.Signal=RCC_OSC_OUT
PF4.Signal=ADC1_IN5
