petrinm/CellShaper/(commit log)

2020-05-08 First draft of the schema and pcb
    [CellShaper.kicad_pcb, CellShaper.sch, cell.sch]
2020-07-06 Progress with the schema and PCB....
    [CellShaper.kicad_pcb, CellShaper.sch, cell.sch, mcu.sch, power.sch]
2020-07-15 Layout done and MCU pins rearranged
    [CellShaper.kicad_pcb, CellShaper.sch, cell.sch, mcu.sch, power.sch]
